SreeniEadara/2018-opensourcebioreactor/electrical/BioreactorPCB/BioreactorPCB.png

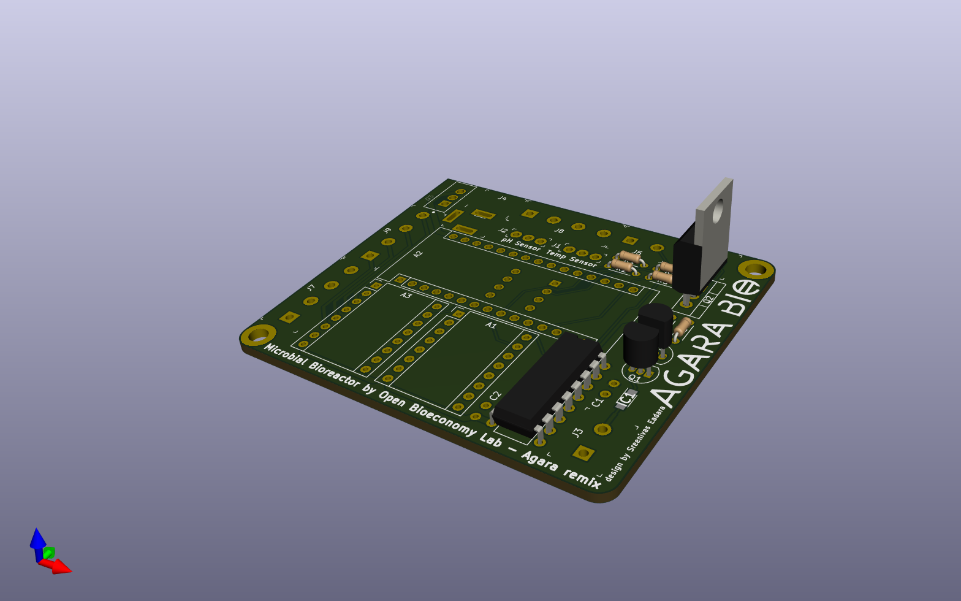
electrical/BioreactorPCB/BioreactorPCB.png
