SreeniEadara/2018-opensourcebioreactor/electrical/BioreactorPCB/Components/LIB_AL5809-20P1-7/AL5809-20P1-7/3D/AL5809-20P1-7.stp

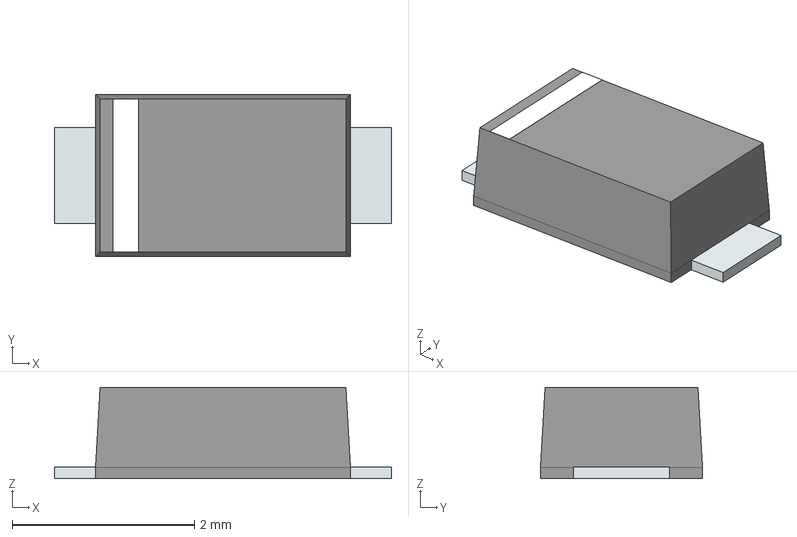
[picture p2: CAD file, 2021-04-17]
electrical/BioreactorPCB/Components/LIB_AL5809-20P1-7/AL5809-20P1-7/3D/AL5809-20P1-7.stp
3.70 x 1.78 x 1.00 mm
PinKIdent
PinK
PinA
