SreeniEadara/2018-opensourcebioreactor/electrical/BioreactorPCB/Components/LIB_GW12RCH/GW12RCH/3D/GW12RCH.stp

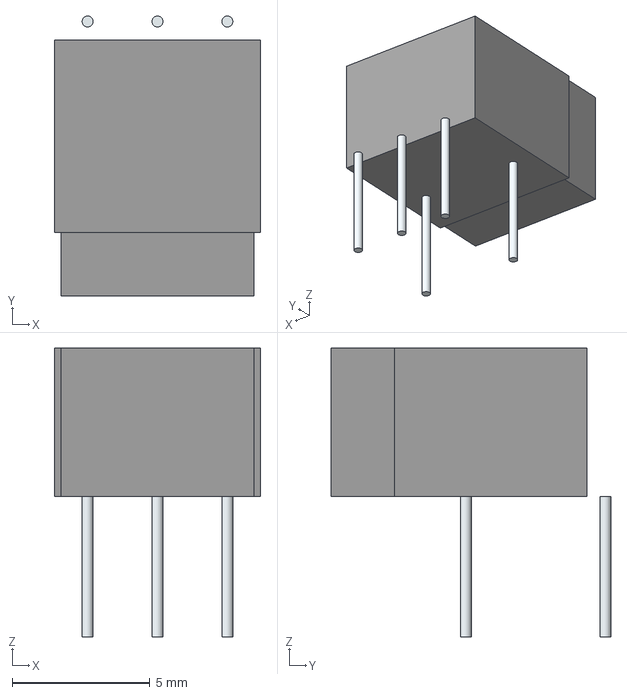
[picture p3: CAD file, 2022-01-01]
electrical/BioreactorPCB/Components/LIB_GW12RCH/GW12RCH/3D/GW12RCH.stp
7.50 x 10.2 x 10.5 mm
Leads x 5
