SreeniEadara/2018-opensourcebioreactor/electrical/BioreactorPCB/Components/LIB_TL2575HV-05IKV/TL2575HV-05IKV/3D/TL2575HV-05IKV.stp

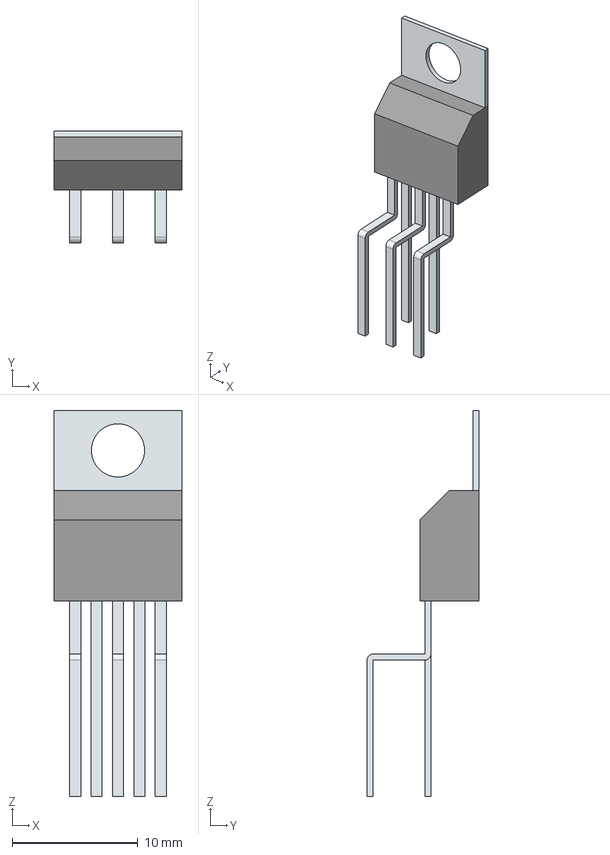
[picture p4: CAD file, 2022-01-02]
electrical/BioreactorPCB/Components/LIB_TL2575HV-05IKV/TL2575HV-05IKV/3D/TL2575HV-05IKV.stp
10.2 x 8.89 x 30.7 mm
Tab
StraightPinsArray
BentPinsArray
