SreeniEadara/2018-opensourcebioreactor/electrical/BioreactorPCB/Components/LIB_TL760M33QKVURQ1/TL760M33QKVURQ1/3D/TL760M33QKVURQ1.stp

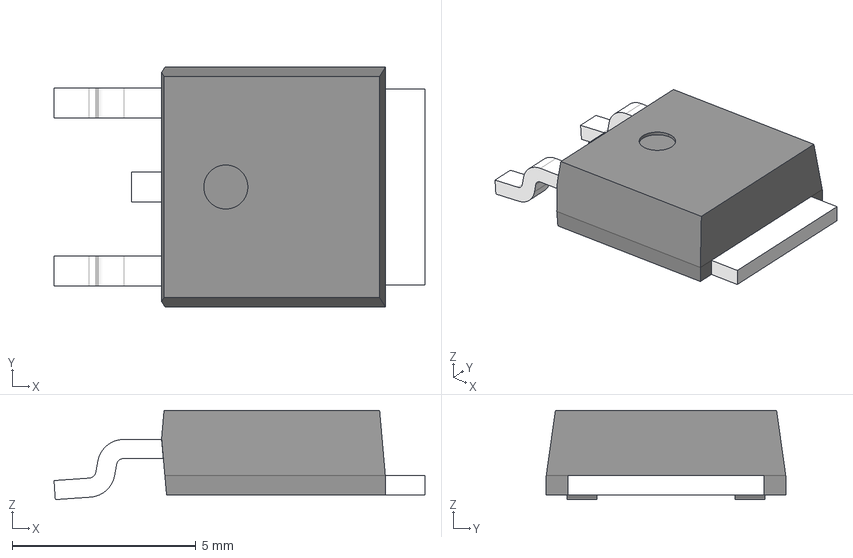
[picture p5: CAD file, 2022-01-02]
electrical/BioreactorPCB/Components/LIB_TL760M33QKVURQ1/TL760M33QKVURQ1/3D/TL760M33QKVURQ1.stp
10.1 x 6.53 x 2.43 mm
BODY-TO
HEATSINK-TO252
LEAD-TO x 2
LEAD-MIDDLE
