SreeniEadara/2018-opensourcebioreactor/Hopkins_CAD/mason_jar_wide_mouth v12.step

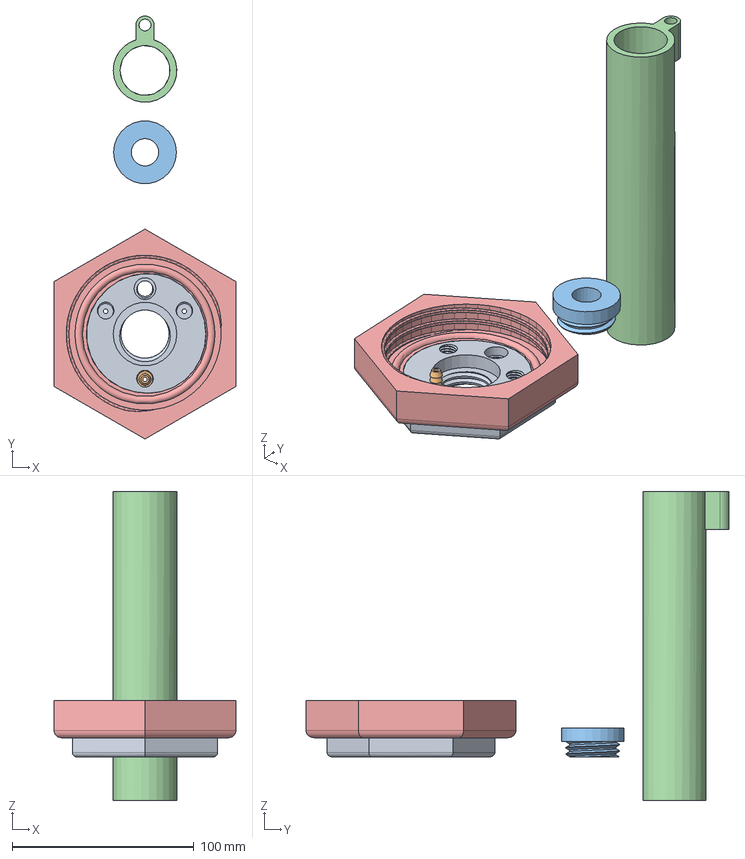
[picture p6: CAD file, 2021-10-21]
Hopkins_CAD/mason_jar_wide_mouth v12.step
100.0 x 232.7 x 170.0 mm
Adapter
Barbed Fitting
pH sensor mount
