SreeniEadara/2018-opensourcebioreactor/electrical/BioreactorPCB/Components/LIB_171856-0006/171856-0006/3D/171856-0006.stp

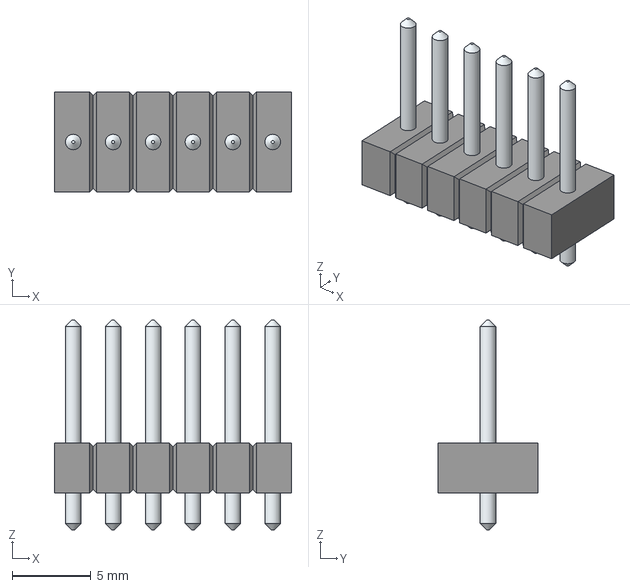
[picture p7: CAD file, 2022-01-01]
electrical/BioreactorPCB/Components/LIB_171856-0006/171856-0006/3D/171856-0006.stp
15.1 x 6.35 x 13.3 mm
LeadsArray
