SreeniEadara/2018-opensourcebioreactor/(list of files, cad)

Other CAD files:
electrical/BioreactorPCB/Components/AgaraLogo/AgaraLogo.dwg
Hopkins_CAD/mason_jar_wide_mouth v12.stl
electrical/BioreactorPCB/Components/LIB_171856-0006/171856-0006/3D/171856-0006.stl
electrical/BioreactorPCB/Components/LIB_171856-0006/171856-0006/Allegro/hdrv6w99p0x254_1x6_1509x635x1100p.psm
electrical/BioreactorPCB/Components/LIB_171856-0006/171856-0006/DEHDL/171856_0006/chips/chips.prt
electrical/BioreactorPCB/Components/LIB_AL5809-20P1-7/AL5809-20P1-7/Allegro/al580920qp17.psm
electrical/BioreactorPCB/Components/LIB_AL5809-20P1-7/AL5809-20P1-7/DEHDL/al5809_20p1_7/chips/chips.prt
electrical/BioreactorPCB/Components/LIB_GW12RCH/GW12RCH/3D/GW12RCH.stl
electrical/BioreactorPCB/Components/LIB_GW12RCH/GW12RCH/Allegro/gw12rch.psm
electrical/BioreactorPCB/Components/LIB_GW12RCH/GW12RCH/DEHDL/gw12rch/chips/chips.prt
electrical/BioreactorPCB/Components/LIB_TL2575HV-05IKV/TL2575HV-05IKV/3D/TL2575HV-05IKV.stl
electrical/BioreactorPCB/Components/LIB_TL2575HV-05IKV/TL2575HV-05IKV/Allegro/to170p470x1016x2338-5p.psm
electrical/BioreactorPCB/Components/LIB_TL2575HV-05IKV/TL2575HV-05IKV/DEHDL/tl2575hv_05ikv/chips/chips.prt
electrical/BioreactorPCB/Components/LIB_TL760M33QKVURQ1/TL760M33QKVURQ1/Allegro/kvu-_r-psfm-g3_.psm
electrical/BioreactorPCB/Components/LIB_TL760M33QKVURQ1/TL760M33QKVURQ1/DEHDL/tl760m33qkvurq1/chips/chips.prt
electrical/BioreactorPCB/Components/LIB_VEML7700-TR/VEML7700-TR/Allegro/veml7700.psm
electrical/BioreactorPCB/Components/LIB_VEML7700-TR/VEML7700-TR/DEHDL/veml7700_tr/chips/chips.prt
