SreeniEadara/2018-opensourcebioreactor/electrical/BioreactorPCB/BioreactorPCB.kicad_pcb

## KiCad design electrical/BioreactorPCB/BioreactorPCB.kicad_pcb (2022-03-21)

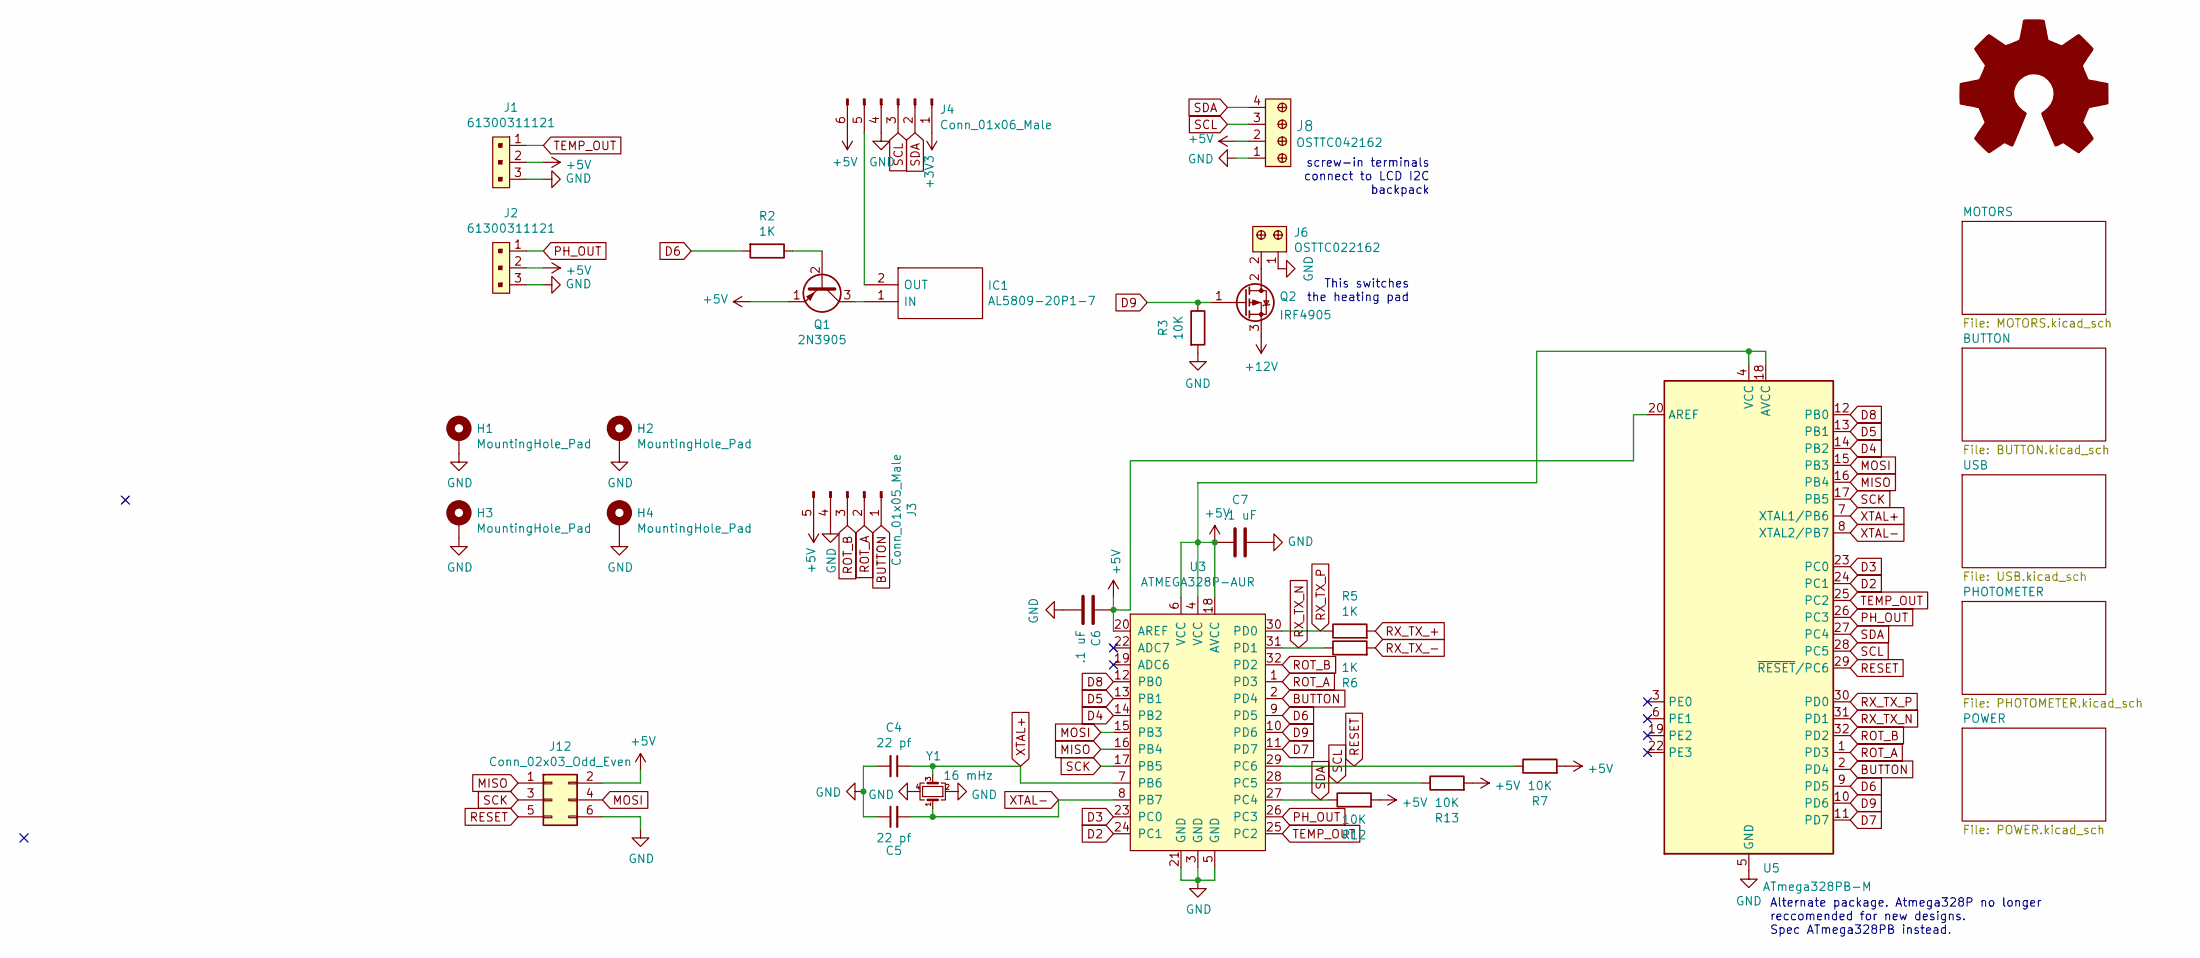
[picture p8: schematic BioreactorPCB.kicad_sch]

Parts:
C4, C5: 22 pf; C_0603_1608Metric_Pad1.08x0.95mm_HandSolder
C6, C7: .1 uF; C_0603_1608Metric_Pad1.08x0.95mm_HandSolder
H1, H2, H3, H4: MountingHole_Pad; MountingHole_3.2mm_M3_DIN965_Pad
IC1: AL5809-20P1-7; AL580920QP17; Manufacturer_Part_Number AL5809-20P1-7; Mouser Part Number 621-AL5809-20P1-7
J1, J2: 61300311121; PinHeader_1x3_P2.54_Drill1.1mm; MPN 61300311121; Digi-Key_PN 732-5316-ND
J3: Conn_01x05_Male; Molex_KK-254_AE-6410-05A_1x05_P2.54mm_Vertical
J4: Conn_01x06_Male; Molex_KK-254_AE-6410-06A_1x06_P2.54mm_Vertical
J6: OSTTC022162; Term_Block_1x2_P5.08MM; MPN OSTTC022162; Digi-Key_PN ED2609-ND
J8: OSTTC042162; Term_Block_1x4_P5.08mm; MPN OSTTC042162; Digi-Key_PN ED2611-ND
J12: Conn_02x03_Odd_Even; PinHeader_2x03_P2.54mm_Vertical
Q1: 2N3905; TO-92_Inline
Q2: IRF4905; TO-262-3_Vertical
R2, R5, R6: 1K; R_0805_2012Metric_Pad1.20x1.40mm_HandSolder
R3, R7, R12, R13: 10K; R_0805_2012Metric_Pad1.20x1.40mm_HandSolder
U3: ATMEGA328P-AUR; TQFP-32_7x7mm; MPN ATMEGA328P-AUR; Digi-Key_PN ATMEGA328P-AURCT-ND
U5: ATmega328PB-M; QFN-32-1EP_5x5mm_P0.5mm_EP3.1x3.1mm
Y1: 16 mHz; Crystal_SMD_3225-4Pin_3.2x2.5mm_HandSoldering

Connections:
+3V3: J4.1; also elsewhere on the board
+5V: C6.1, C7.2, J1.2, J2.2, J3.5, J4.6, J8.2, J12.2, Q1.1 (E), R7.2, R12.2, R13.2, U3.4 (VCC), U3.6 (VCC), U3.18 (AVCC), U3.20 (AREF), U5.4 (VCC), U5.18 (AVCC), U5.20 (AREF); also elsewhere on the board
+12V: Q2.3 (S); also elsewhere on the board
BUTTON: J3.1, U3.2 (PD4), U5.2 (PD4)
D2: U3.24 (PC1), U5.24 (PC1); also elsewhere on the board
D3: U3.23 (PC0), U5.23 (PC0); also elsewhere on the board
D4: U3.14 (PB2), U5.14 (PB2); also elsewhere on the board
D5: U3.13 (PB1), U5.13 (PB1); also elsewhere on the board
D6: R2.2, U3.9 (PD5), U5.9 (PD5)
D7: U3.11 (PD7), U5.11 (PD7); also elsewhere on the board
D8: U3.12 (PB0), U5.12 (PB0); also elsewhere on the board
D9: Q2.1 (G), R3.1, U3.10 (PD6), U5.10 (PD6)
GND: C4.2, C5.1, C6.2, C7.1, H1.1, H2.1, H3.1, H4.1, J1.3, J2.3, J3.4, J4.4, J6.1, J8.1, J12.6, R3.2, U3.3 (GND), U3.5 (GND), U3.21 (GND), U5.5 (GND), U5.21 (GND), U5.33 (GND), Y1.2, Y1.4; also elsewhere on the board
MISO: J12.1, U3.16 (PB4), U5.16 (PB4)
MOSI: J12.4, U3.15 (PB3), U5.15 (PB3)
unnamed: IC1.1 (IN), Q1.3 (C)
unnamed: IC1.2 (OUT), J4.5
unnamed: J6.2, Q2.2 (D)
unnamed: Q1.2 (B), R2.1
PH_OUT: J2.1, U3.26 (PC3), U5.26 (PC3)
RESET: J12.5, R7.1, U3.29 (PC6), U5.29 (~RESET/PC6); also elsewhere on the board
ROT_A: J3.2, U3.1 (PD3), U5.1 (PD3)
ROT_B: J3.3, U3.32 (PD2), U5.32 (PD2)
RX_TX_+: R5.2; also elsewhere on the board
RX_TX_-: R6.2; also elsewhere on the board
RX_TX_N: R6.1, U3.31 (PD1), U5.31 (PD1)
RX_TX_P: R5.1, U3.30 (PD0), U5.30 (PD0)
SCK: J12.3, U3.17 (PB5), U5.17 (PB5)
SCL: J4.3, J8.3, R13.1, U3.28 (PC5), U5.28 (PC5)
SDA: J4.2, J8.4, R12.1, U3.27 (PC4), U5.27 (PC4)
TEMP_OUT: J1.1, U3.25 (PC2), U5.25 (PC2)
XTAL+: C4.1, U3.7 (PB6), U5.7 (XTAL1/PB6), Y1.3
XTAL-: C5.2, U3.8 (PB7), U5.8 (XTAL2/PB7), Y1.1

Notes on the sheet:
This switches the heating pad
screw-in terminals connect to LCD I2C backpack
Alternate package. Atmega328P no longer reccomended for new designs. Spec ATmega328PB instead.

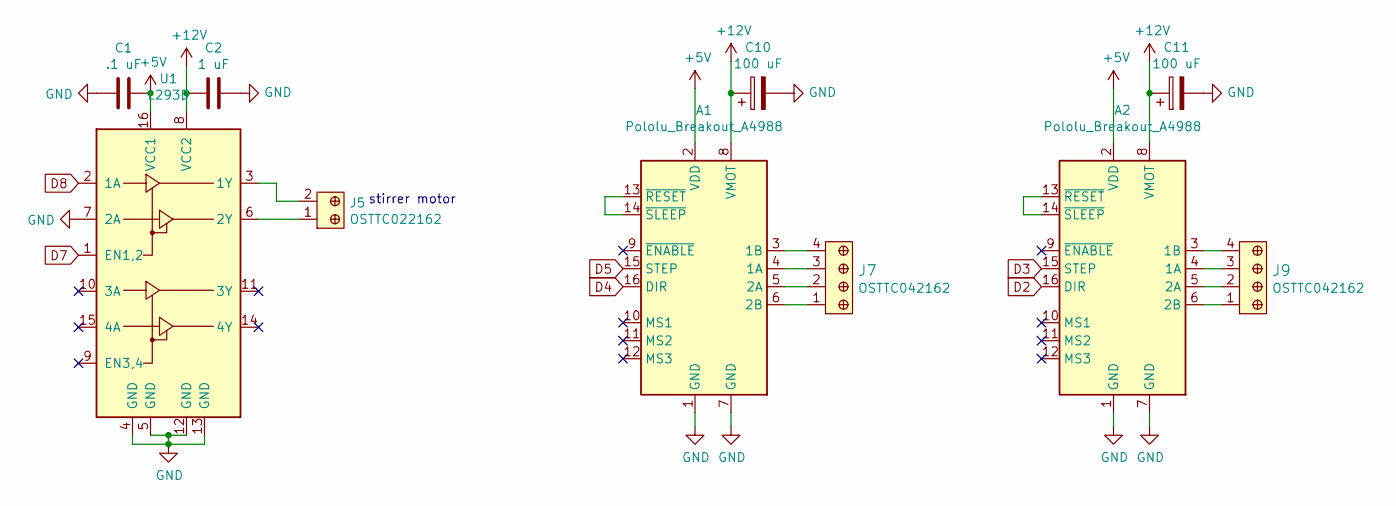
[picture p9: schematic MOTORS.kicad_sch]

Parts:
A1, A2: Pololu_Breakout_A4988; Pololu_Breakout-16_15.2x20.3mm
C1: .1 uF; C_0603_1608Metric_Pad1.08x0.95mm_HandSolder
C2: 1 uF; C_0603_1608Metric_Pad1.08x0.95mm_HandSolder
C10, C11: 100 uF; CP_Radial_D5.0mm_P2.50mm
J5: OSTTC022162; Term_Block_1x2_P5.08MM; MPN OSTTC022162; Digi-Key_PN ED2609-ND
J7, J9: OSTTC042162; Term_Block_1x4_P5.08mm; MPN OSTTC042162; Digi-Key_PN ED2611-ND
U1: L293D; DIP-16_W7.62mm

Connections:
+5V: A1.2 (VDD), A2.2 (VDD), C1.1, U1.16 (VCC1); also elsewhere on the board
+12V: A1.8 (VMOT), A2.8 (VMOT), C2.2, C10.1, C11.1, U1.8 (VCC2); also elsewhere on the board
D2: A2.16 (DIR); also elsewhere on the board
D3: A2.15 (STEP); also elsewhere on the board
D4: A1.16 (DIR); also elsewhere on the board
D5: A1.15 (STEP); also elsewhere on the board
D7: U1.1 (EN1,2); also elsewhere on the board
D8: U1.2 (1A); also elsewhere on the board
GND: A1.1 (GND), A1.7 (GND), A2.1 (GND), A2.7 (GND), C1.2, C2.1, C10.2, C11.2, U1.4 (GND), U1.5 (GND), U1.7 (2A), U1.12 (GND), U1.13 (GND); also elsewhere on the board
unnamed: A1.3 (1B), J7.4
unnamed: A1.4 (1A), J7.3
unnamed: A1.5 (2A), J7.2
unnamed: A1.6 (2B), J7.1
unnamed: A1.13 (~RESET), A1.14 (~SLEEP)
unnamed: A2.3 (1B), J9.4
unnamed: A2.4 (1A), J9.3
unnamed: A2.5 (2A), J9.2
unnamed: A2.6 (2B), J9.1
unnamed: A2.13 (~RESET), A2.14 (~SLEEP)
unnamed: J5.1, U1.6 (2Y)
unnamed: J5.2, U1.3 (1Y)

Notes on the sheet:
stirrer motor

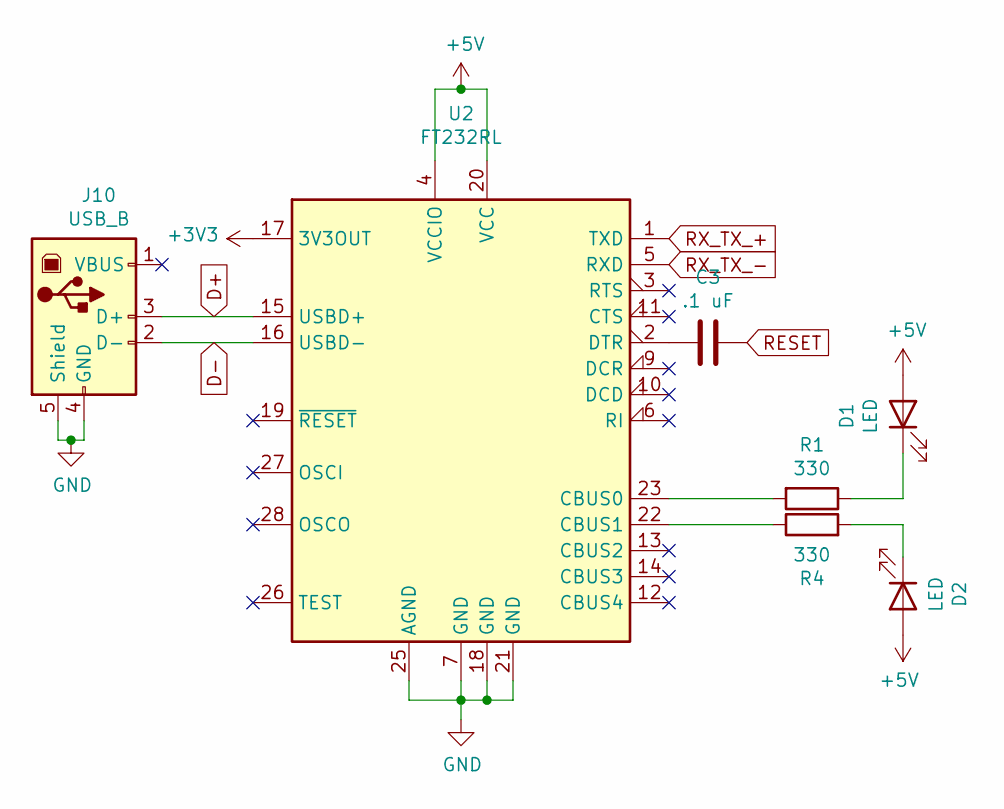
[picture p10: schematic USB.kicad_sch]

Parts:
C3: .1 uF; C_0603_1608Metric_Pad1.08x0.95mm_HandSolder
D1, D2: LED; LED_D5.0mm
J10: USB_B; USB_B_Lumberg_2411_02_Horizontal
R1, R4: 330; R_0805_2012Metric_Pad1.20x1.40mm_HandSolder
U2: FT232RL; SSOP-28_5.3x10.2mm_P0.65mm

Connections:
+3V3: U2.17 (3V3OUT); also elsewhere on the board
+5V: D1.2 (A), D2.2 (A), U2.4 (VCCIO), U2.20 (VCC); also elsewhere on the board
D+: J10.3 (D+), U2.15 (USBD+)
D-: J10.2 (D-), U2.16 (USBD-)
GND: J10.4 (GND), J10.5 (Shield), U2.7 (GND), U2.18 (GND), U2.21 (GND), U2.25 (AGND); also elsewhere on the board
unnamed: C3.2, U2.2 (DTR)
unnamed: D1.1 (K), R1.1
unnamed: D2.1 (K), R4.2
unnamed: R1.2, U2.23 (CBUS0)
unnamed: R4.1, U2.22 (CBUS1)
RESET: C3.1; also elsewhere on the board
RX_TX_+: U2.1 (TXD); also elsewhere on the board
RX_TX_-: U2.5 (RXD); also elsewhere on the board

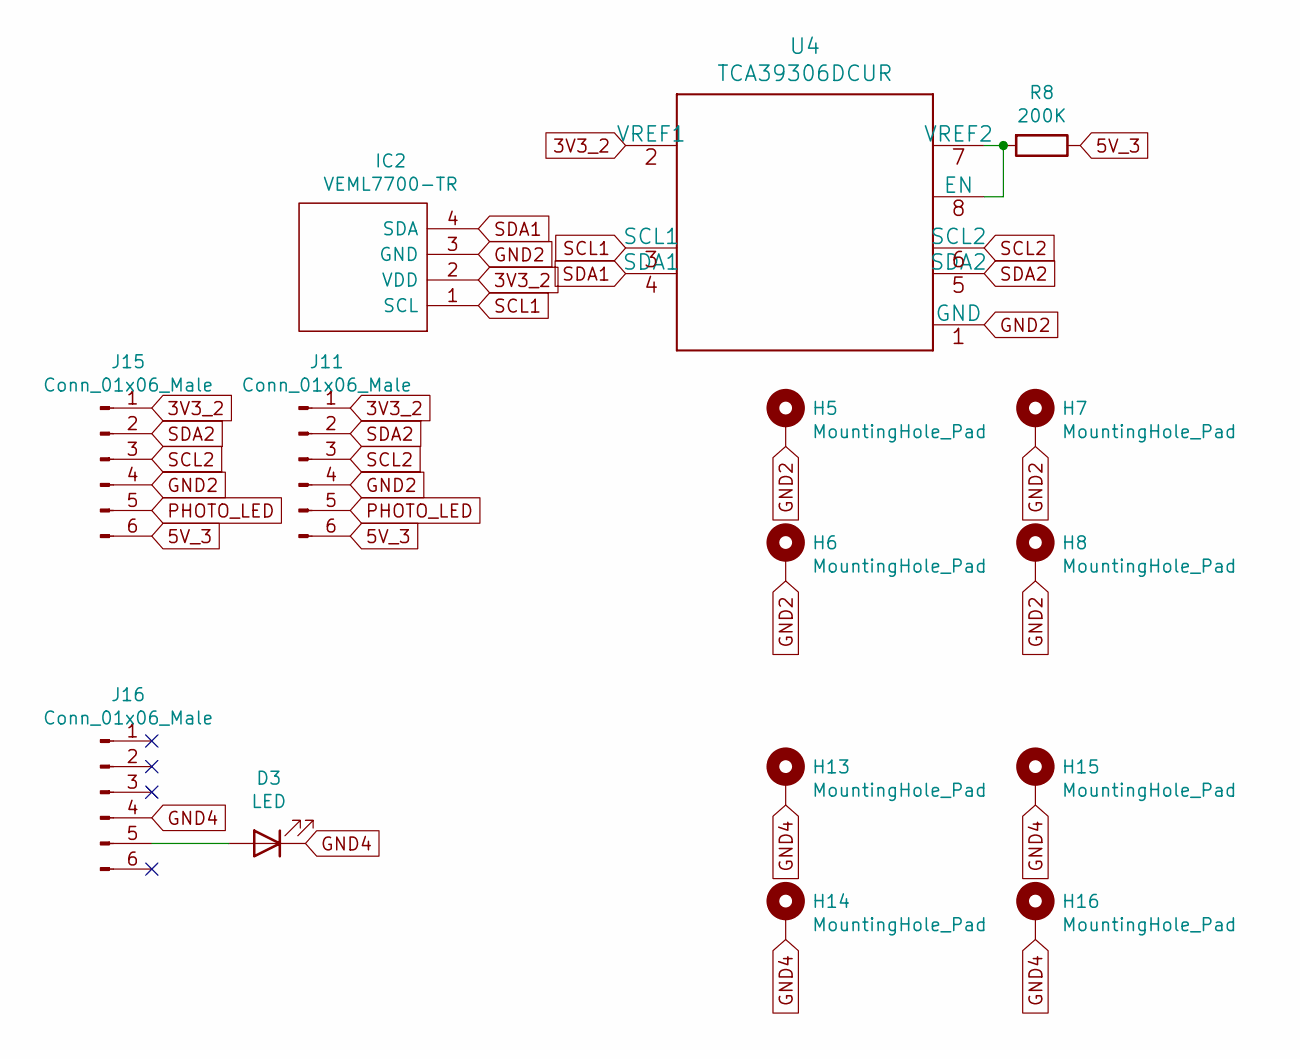
[picture p11: schematic PHOTOMETER.kicad_sch]

Parts:
D3: LED; LED_D5.0mm
H5, H6, H7, H8, H13, H14, H15, H16: MountingHole_Pad; MountingHole_3.2mm_M3_DIN965_Pad
IC2: VEML7700-TR; VEML7700; Manufacturer_Part_Number VEML7700-TR; Mouser Part Number 78-VEML7700-TR
J11, J15, J16: Conn_01x06_Male; Molex_KK-254_AE-6410-06A_1x06_P2.54mm_Vertical
R8: 200K; R_0805_2012Metric_Pad1.20x1.40mm_HandSolder
U4: TCA39306DCUR

Connections:
3V3_2: IC2.2 (VDD), J11.1, J15.1, U4.2 (VREF1)
5V_3: J11.6, J15.6, R8.1
GND2: H5.1, H6.1, H7.1, H8.1, IC2.3 (GND), J11.4, J15.4, U4.1 (GND)
GND4: D3.1 (K), H13.1, H14.1, H15.1, H16.1, J16.4
unnamed: D3.2 (A), J16.5
unnamed: R8.2, U4.7 (VREF2), U4.8 (EN)
PHOTO_LED: J11.5, J15.5
SCL1: IC2.1 (SCL), U4.3 (SCL1)
SCL2: J11.3, J15.3, U4.6 (SCL2)
SDA1: IC2.4 (SDA), U4.4 (SDA1)
SDA2: J11.2, J15.2, U4.5 (SDA2)

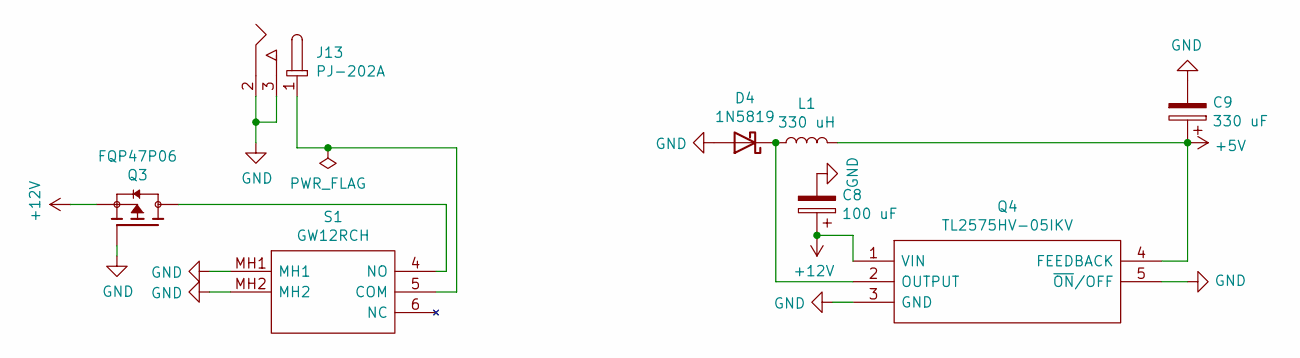
[picture p12: schematic POWER.kicad_sch]

Parts:
C8: 100 uF; CP_Radial_D5.0mm_P2.50mm
C9: 330 uF; CP_Radial_D5.0mm_P2.50mm
D4: 1N5819; D_DO-41_SOD81_P10.16mm_Horizontal
J13: PJ-202A; Barrel_Jack_5.5mmODx2.1mmID_PJ-202A; MPN PJ-202A; Digi-Key_PN CP-202A-ND
L1: 330 uH; L_Bourns_SRR1210A
Q3: FQP47P06; TO-220-3_Vertical
Q4: TL2575HV-05IKV; TO-220-5_P3.4x3.7mm_StaggerEven_Lead3.8mm_Vertical; Manufacturer_Part_Number TL2575HV-05IKV; Mouser Part Number 595-TL2575HV-05IKV
S1: GW12RCH; Manufacturer_Part_Number GW12RCH; Mouser Part Number 633-GW12RCH

Connections:
+5V: C9.1, L1.2, Q4.4 (FEEDBACK); also elsewhere on the board
+12V: C8.1, Q3.3, Q4.1 (VIN); also elsewhere on the board
GND: C8.2, C9.2, D4.2 (A), J13.2, J13.3, Q3.1, Q4.3 (GND), Q4.5 (~ON/OFF), S1.MH1, S1.MH2; also elsewhere on the board
unnamed: D4.1 (K), L1.1, Q4.2 (OUTPUT)
unnamed: J13.1, S1.5 (COM)
unnamed: Q3.2, S1.4 (NO)

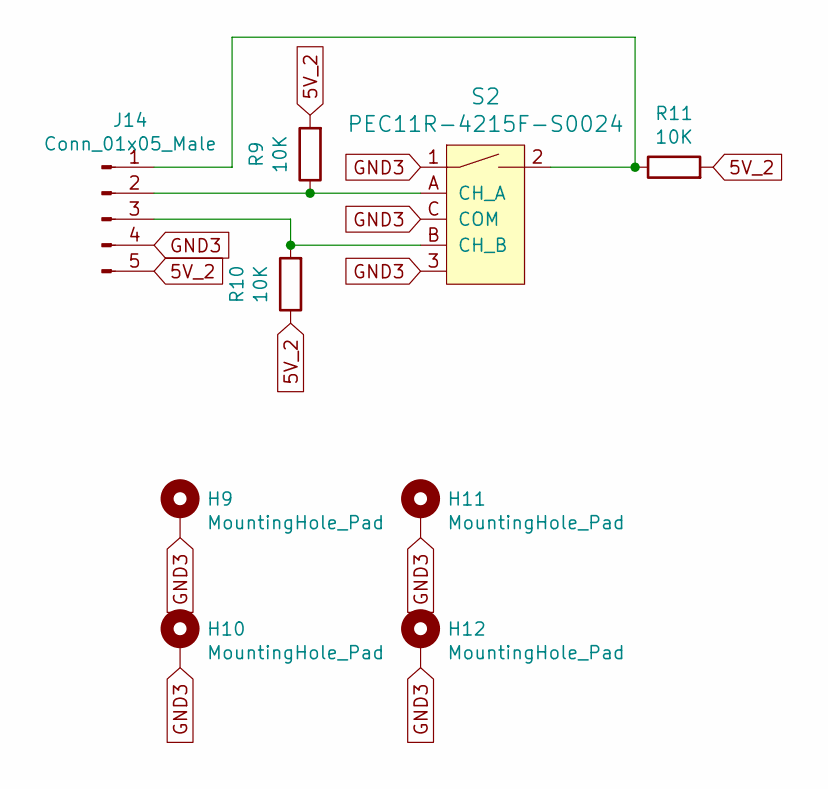
[picture p13: schematic BUTTON.kicad_sch]

Parts:
H9, H10, H11, H12: MountingHole_Pad; MountingHole_3.2mm_M3_DIN965_Pad
J14: Conn_01x05_Male; Molex_KK-254_AE-6410-05A_1x05_P2.54mm_Vertical
R9, R10, R11: 10K; R_0805_2012Metric_Pad1.20x1.40mm_HandSolder
S2: PEC11R-4215F-S0024; Rotary_Encoder_Switched_PEC11R; MPN PEC11R-4215F-S0024; Digi-Key_PN PEC11R-4215F-S0024-ND

Connections:
5V_2: J14.5, R9.2, R10.1, R11.2
GND3: H9.1, H10.1, H11.1, H12.1, J14.4, S2.1, S2.3, S2.C (COM)
unnamed: J14.1, R11.1, S2.2
unnamed: J14.2, R9.1, S2.A (CH_A)
unnamed: J14.3, R10.2, S2.B (CH_B)

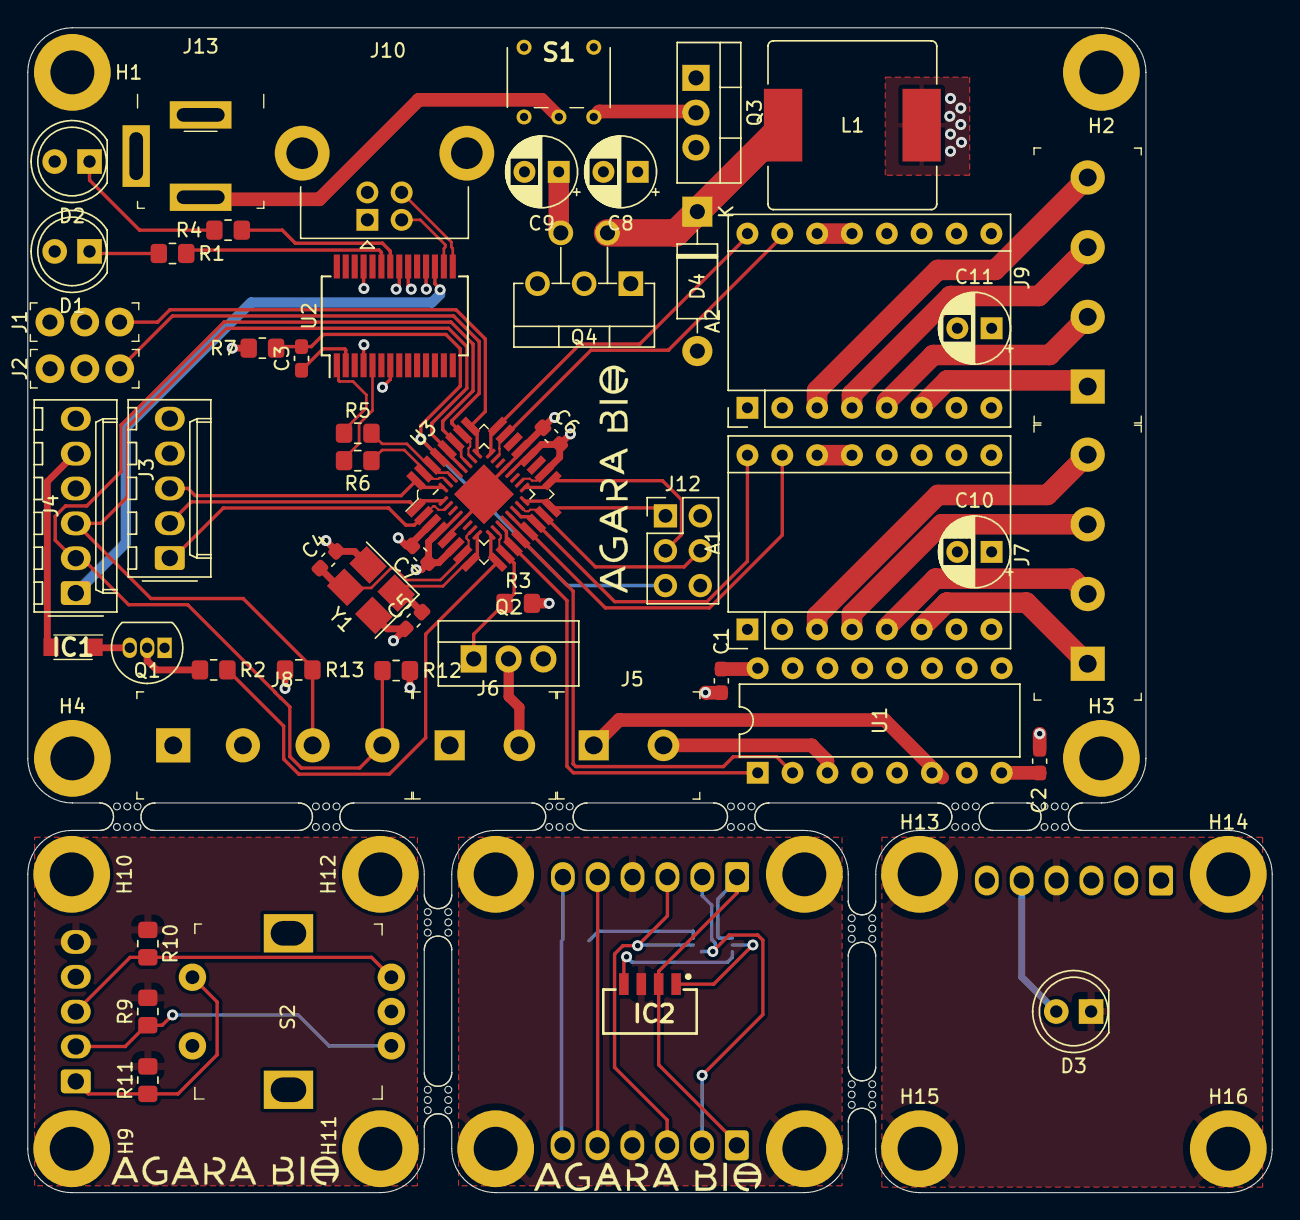
[picture p14: board BioreactorPCB.kicad_pcb from above]

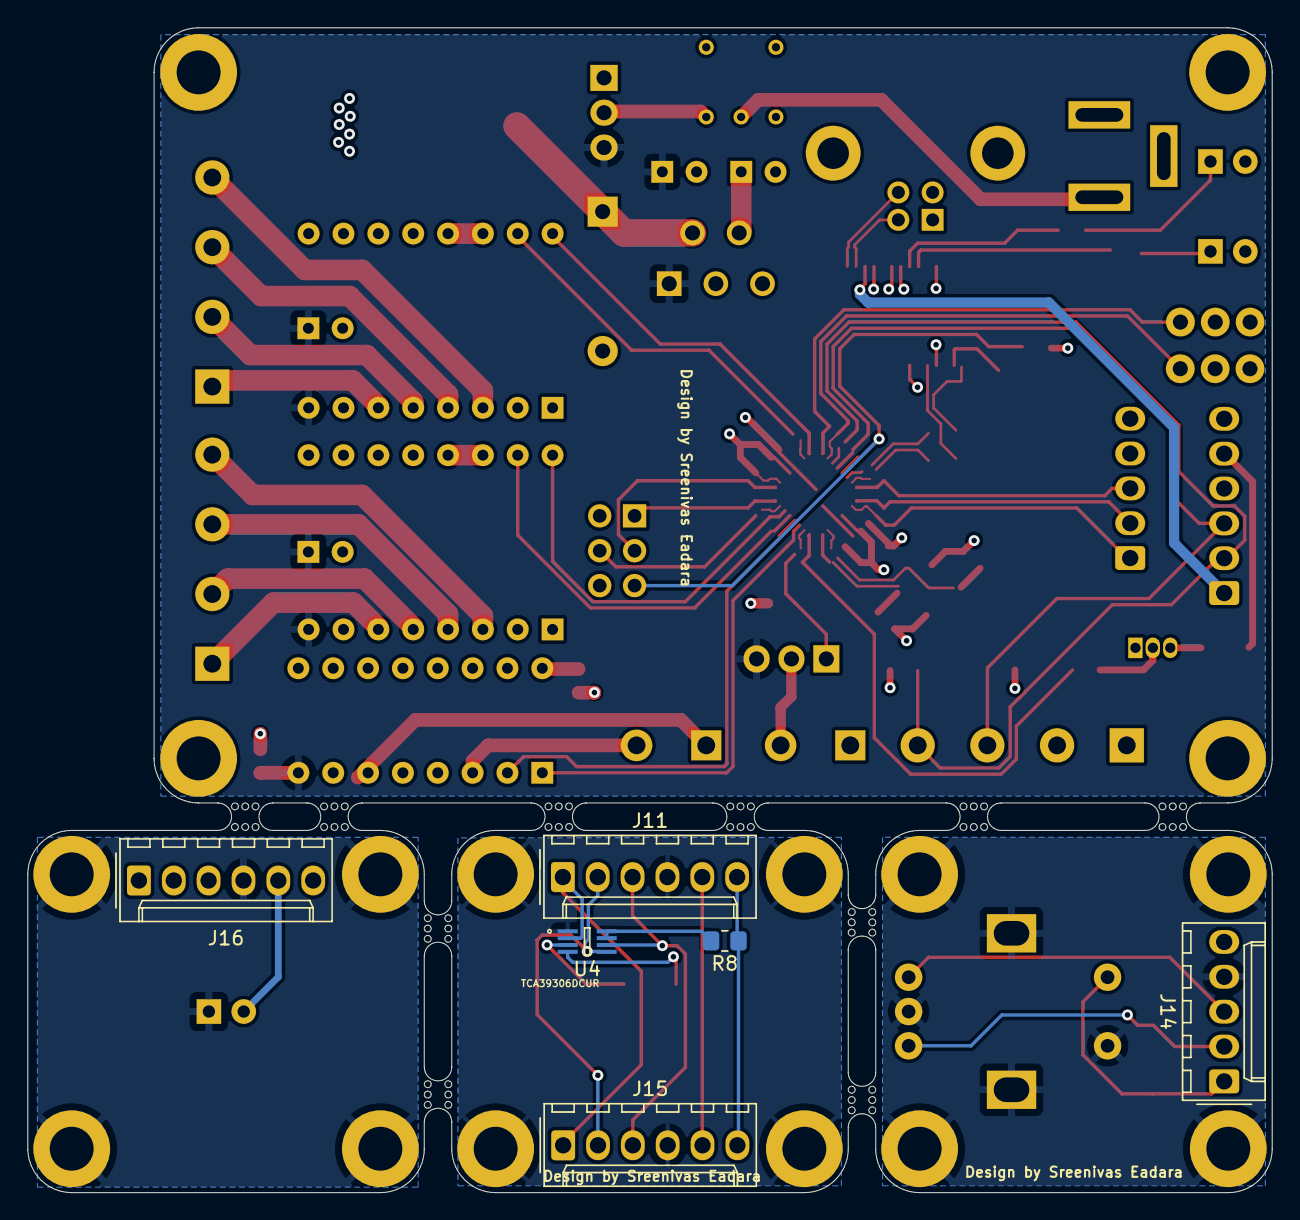
[picture p15: board BioreactorPCB.kicad_pcb from below]

Board: 4 copper layers, 90.7 x 84.9 mm, 87 parts (6 on the bottom side), 71 nets.

Other parts of the board:
mouse-bite-2mm-slot, mouse-bite-2mm-slot#2, mouse-bite-2mm-slot#3, mouse-bite-2mm-slot#4, mouse-bite-2mm-slot#5, mouse-bite-2mm-slot#6, mouse-bite-2mm-slot#7, mouse-bite-2mm-slot#8, mouse-bite-2mm-slot#9, mouse-bite-2mm-slot#10: VAL**; mouse-bite-2mm-slot
