SreeniEadara/2018-opensourcebioreactor/(commit log)

2021-04-17 Adding Agara Bio PCB design for bioreactor and flow-through photometer. ~Designed by Sreenivas Eadara~
    [AL5809-20P1-7.stp, AgaraLogo.dwg, BioreactorPCB.kicad_pcb, BioreactorPCB.sch, EDI2CAP.CFG, al580920qp17.psm, chips.prt]
2021-10-21 Arduino code is validated and working on Arduino Nano Every and board layout updated to match latest.
    [BioreactorPCB-B_Cu.gbr, BioreactorPCB-B_Mask.gbr, BioreactorPCB-B_SilkS.gbr, BioreactorPCB-Edge_Cuts.gbr, BioreactorPCB-F_Cu.gbr, BioreactorPCB-F_Mask.gbr, BioreactorPCB-F_SilkS.gbr, BioreactorPCB-NPTH.drl]
2021-10-21 Added .STEP and .STL files designed by James Li
    [mason_jar_wide_mouth v12.step, mason_jar_wide_mouth v12.stl]
2022-01-01 PCB rev 2.0 development underway
    [171856-0006.stl, 171856-0006.stp, BioreactorPCB.kicad_pcb, BioreactorPCB.sch, EDI2CAP.CFG, GW12RCH.stl, GW12RCH.stp, chips.prt]
2022-01-02 another intermediate
    [BioreactorPCB.sch, EDI2CAP.CFG, TL2575HV-05IKV.stl, TL2575HV-05IKV.stp, TL760M33QKVURQ1.stp, chips.prt, kvu-_r-psfm-g3_.psm, to170p470x1016x2338-5p.psm]
2022-01-02 Rev 2.0 schematic ready
    [BioreactorPCB.sch]
2022-01-02 updates WIP to v 2.0
    [BioreactorPCB.sch]
2022-01-03 Completed rev 2.0 schematic for real now
    [BUTTON.sch, BioreactorPCB.kicad_pcb, BioreactorPCB.sch, MOTORS.sch, PHOTOMETER.sch, POWER.sch, USB.sch]
2022-01-04 added missing electrolytic capacitors for A4988 breakouts. Preliminary layout now in place
    [BioreactorPCB.kicad_pcb, BioreactorPCB.sch, MOTORS.sch, POWER.sch, USB.sch]
2022-01-05 motherboard layout complete.
    [BioreactorPCB.kicad_pcb, BioreactorPCB.sch, USB.sch]
2022-01-05 moved a couple traces
    [BioreactorPCB.kicad_pcb]
2022-01-05 Converted all nonpolarized resistors and capacitors to SMD. USB now has differential pairs that conform to design guidelines. Lots of traces, to what end? idk.
    [BUTTON.sch, BioreactorPCB.kicad_pcb, BioreactorPCB.sch, MOTORS.sch, PHOTOMETER.sch, USB.sch]
2022-01-05 literally just moved some labels
    [BioreactorPCB.kicad_pcb]
2022-01-05 More routing changes for greater plane continuity
    [BioreactorPCB.kicad_pcb]
2022-01-05 Moved around some traces for better planes
    [BioreactorPCB.kicad_pcb]
2022-01-06 finished daughterboards
    [BioreactorPCB.kicad_pcb]
2022-01-06 panelized completed daughterboards and added clearance of planes to board edge
    [BioreactorPCB.kicad_pcb]
2022-01-06 added silk labels
    [BioreactorPCB.kicad_pcb]
2022-01-08 changed layout and schematic to reflect addition of a third daughterboard and separation of the LED and photodiode onto separate boards
    [BioreactorPCB.csv, BioreactorPCB.kicad_pcb, PHOTOMETER.sch]
2022-01-10 Updated BOM with cables and DigiKey PNs
    [BioreactorPCB.csv]
2022-02-07 Added 10K pullups on the i2c SDA and SCL. Apparently AVR internal pullups are too weak! Oops.
    [BUTTON.kicad_sch, BioreactorPCB.kicad_pcb, BioreactorPCB.kicad_sch, MOTORS.kicad_sch, PHOTOMETER.kicad_sch, POWER.kicad_sch, USB.kicad_sch]
2022-02-07 cleanup of tracks and plane
    [BioreactorPCB.kicad_pcb]
2022-02-23 Added alternate Atmega328PB 32QFN package and rerouted board to match
    [BioreactorPCB.kicad_pcb, BioreactorPCB.kicad_sch]
2022-02-23 some track cleanup
    [BioreactorPCB.kicad_pcb]
2022-02-24 many improvements to ground plane at some expense to 5V plane
    [BioreactorPCB.kicad_pcb]
2022-02-25 Removed vias in pad (so sad to see them go, but I'm not made of money) and set min track width and spacing to 6 mil
    [BioreactorPCB.kicad_pcb]
2022-02-26 Replaced through-hole crystal with SMD package and moved capacitors so they actually decouple the MCU
    [BioreactorPCB.kicad_pcb, BioreactorPCB.kicad_sch]
2022-02-26 changed MOSFET to PFET and made the heater switched by a high-side switch
    [BioreactorPCB.kicad_pcb, BioreactorPCB.kicad_sch]
2022-03-11 NOW a 4-layer pCB with drastically improved routing
    [BioreactorPCB.kicad_pcb, BioreactorPCB.kicad_sch, POWER.kicad_sch]
2022-03-11 +12V is now bottom copper plane
    [BioreactorPCB.kicad_pcb]
2022-03-21 increeased stepper motor trace width. Miscellaneous improvements
    [BioreactorPCB.kicad_pcb]
