SreeniEadara/2018-opensourcebioreactor/(notices)

Notices in the files:
parts and their libraries:
Copyright 2021 Accelerated Designs. All rights reserved.
